SwadeDotExe/ESP32-Power-Meter/(commit log)

2022-06-10 Completed calibration
2022-06-13 Added schematics
